adafruit/Adafruit-Mini-TFT-with-Joystick-Featherwing-PCB/Adafruit Mini TFT Wing.brd

## EAGLE design Adafruit Mini TFT Wing.brd (2018-11-03)

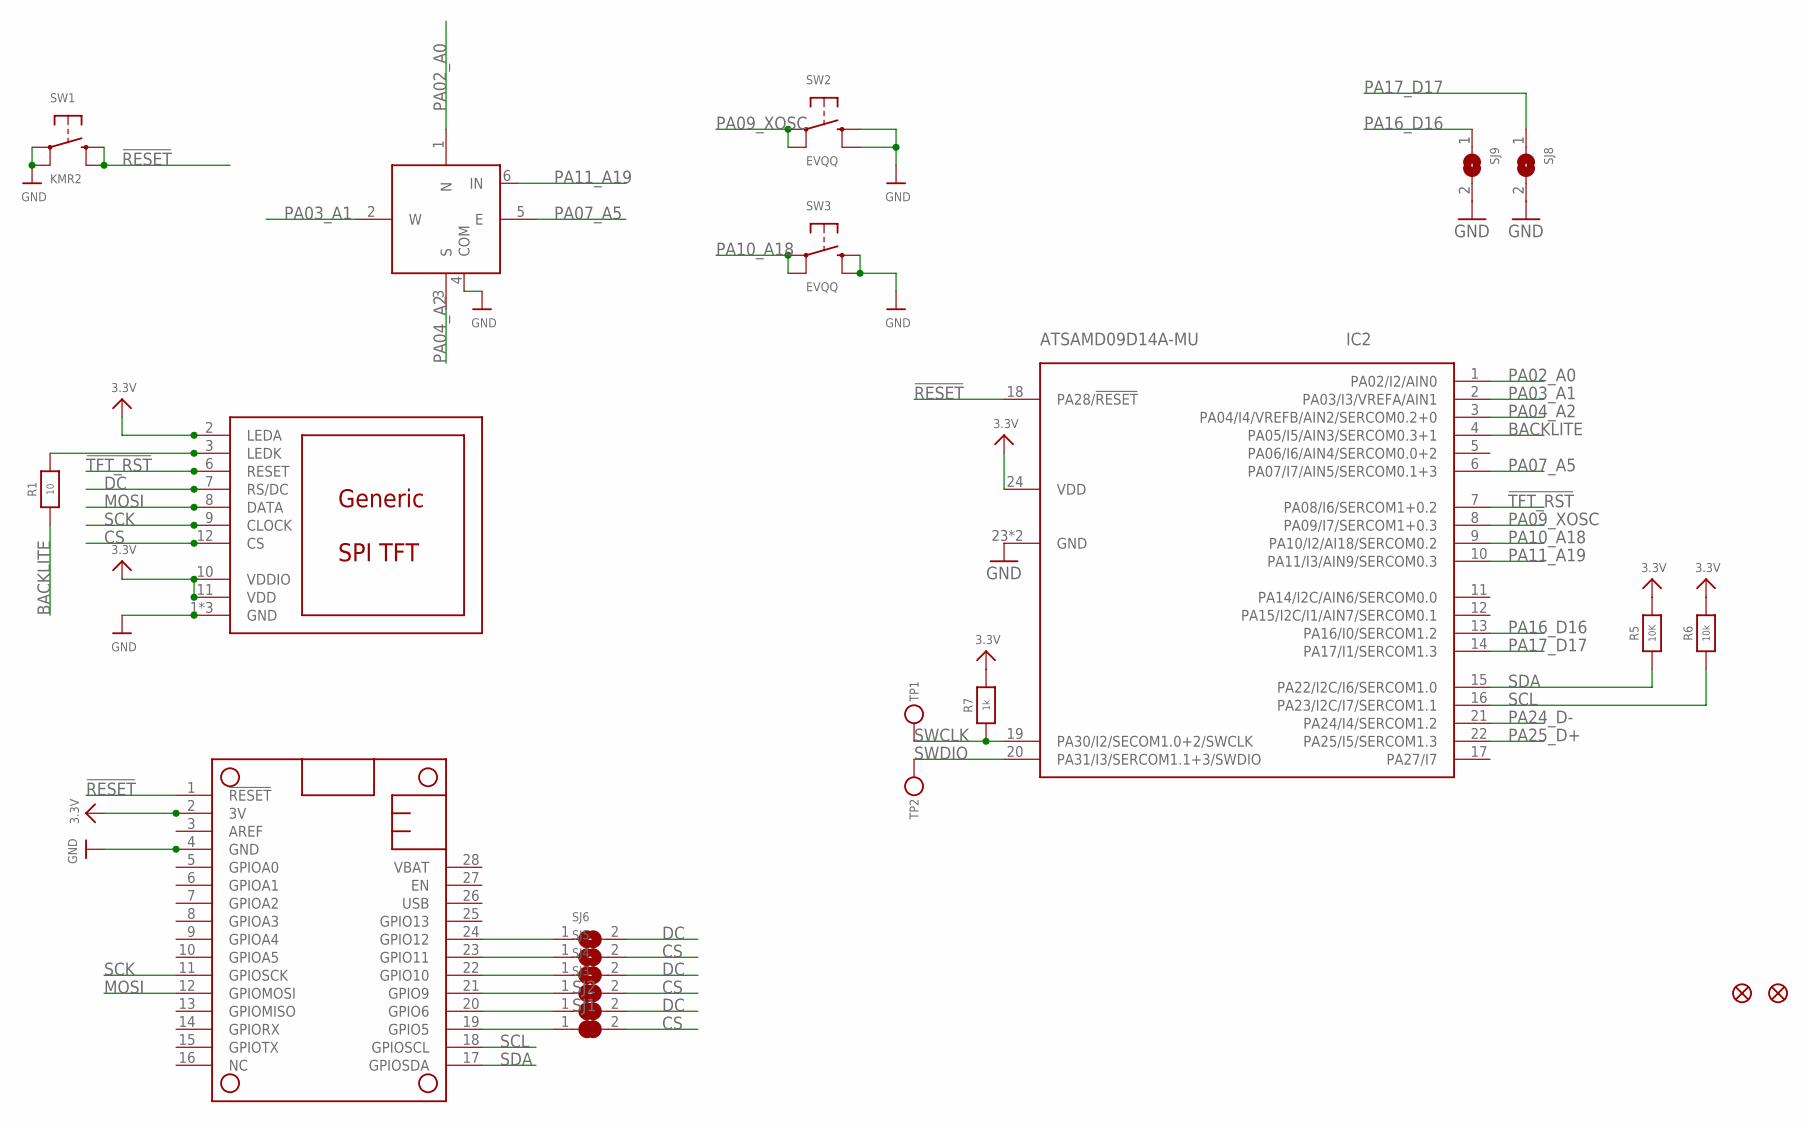
[picture p2: schematic Adafruit Mini TFT Wing.sch]

Parts:
FID1, FID2: FIDUCIAL_1MM
IC2: ATSAMD09D14A-MU; QFN24_4MM
MS1: FEATHERWING
R1: 10; 0603-NO
R5: 10K; 0603-NO
R6: 10k; 0603-NO
R7: 1k; 0603-NO
SJ1, SJ2: SOLDERJUMPER_CLOSED; SOLDERJUMPER_CLOSEDWIRE
SJ3, SJ4, SJ5, SJ6, SJ8, SJ9: SOLDERJUMPER; SOLDERJUMPER_ARROW_NOPASTE
SW1: KMR2; BTN_KMR2_4.6X2.8
SW2, SW3: EVQQ; EVQ-Q2_SMALLER
SW4: NAVSWITCHSKQUABAUE010; SKQUBAE010
TP1, TP2: TESTPOINTROUND2MM; TESTPOINT_ROUND_2MM
U$2: DISP_LCD_0.9IN_160X80; TFT_0.96IN_160X80

Connections:
3.3V: IC2.24 (VDD), MS1.2 (3V), R5.2, R6.2, R7.2, U$2.2 (LEDA), U$2.10 (VDDIO), U$2.11 (VDD)
!RESET: IC2.18 (PA28/!RESET), MS1.1 (!RESET), SW1.B (S), SW1.B' (S1)
!TFT_RST: IC2.7 (PA08/I6/SERCOM1+0.2), U$2.6 (RESET)
BACKLITE: IC2.4 (PA05/I5/AIN3/SERCOM0.3+1), R1.1
CS: SJ1.2, SJ3.2, SJ5.2, U$2.12 (CS)
DC: SJ2.2, SJ4.2, SJ6.2, U$2.7 (RS/DC)
GND: IC2.23 (GND), IC2.THERM (GND), MS1.4 (GND), SJ8.2, SJ9.2, SW1.A, SW1.A' (P1), SW2.B (S), SW2.B' (S1), SW3.B (S), SW3.B' (S1), SW4.4 (COM), U$2.1 (GND), U$2.5 (GND), U$2.13 (GND)
MOSI: MS1.12 (GPIOMOSI), U$2.8 (DATA)
unnamed: MS1.20 (GPIO6), SJ2.1
unnamed: MS1.19 (GPIO5), SJ1.1
unnamed: MS1.21 (GPIO9), SJ3.1
unnamed: MS1.22 (GPIO10), SJ4.1
unnamed: MS1.23 (GPIO11), SJ5.1
unnamed: MS1.24 (GPIO12), SJ6.1
unnamed: R1.2, U$2.3 (LEDK)
PA02_A0: IC2.1 (PA02/I2/AIN0), SW4.1 (N)
PA03_A1: IC2.2 (PA03/I3/VREFA/AIN1), SW4.2 (W)
PA04_A2: IC2.3 (PA04/I4/VREFB/AIN2/SERCOM0.2+0), SW4.3 (S)
PA07_A5: IC2.6 (PA07/I7/AIN5/SERCOM0.1+3), SW4.5 (E)
PA09_XOSC: IC2.8 (PA09/I7/SERCOM1+0.3), SW2.A, SW2.A' (P1)
PA10_A18: IC2.9 (PA10/I2/AI18/SERCOM0.2), SW3.A, SW3.A' (P1)
PA11_A19: IC2.10 (PA11/I3/AIN9/SERCOM0.3), SW4.6 (IN)
PA16_D16: IC2.13 (PA16/I0/SERCOM1.2), SJ9.1
PA17_D17: IC2.14 (PA17/I1/SERCOM1.3), SJ8.1
PA24_D-: IC2.21 (PA24/I4/SERCOM1.2)
PA25_D+: IC2.22 (PA25/I5/SERCOM1.3)
SCK: MS1.11 (GPIOSCK), U$2.9 (CLOCK)
SCL: IC2.16 (PA23/I2C/I7/SERCOM1.1), MS1.18 (GPIOSCL), R6.1
SDA: IC2.15 (PA22/I2C/I6/SERCOM1.0), MS1.17 (GPIOSDA), R5.1
SWCLK: IC2.19 (PA30/I2/SECOM1.0+2/SWCLK), R7.1, TP1.P$1
SWDIO: IC2.20 (PA31/I3/SERCOM1.1+3/SWDIO), TP2.P$1

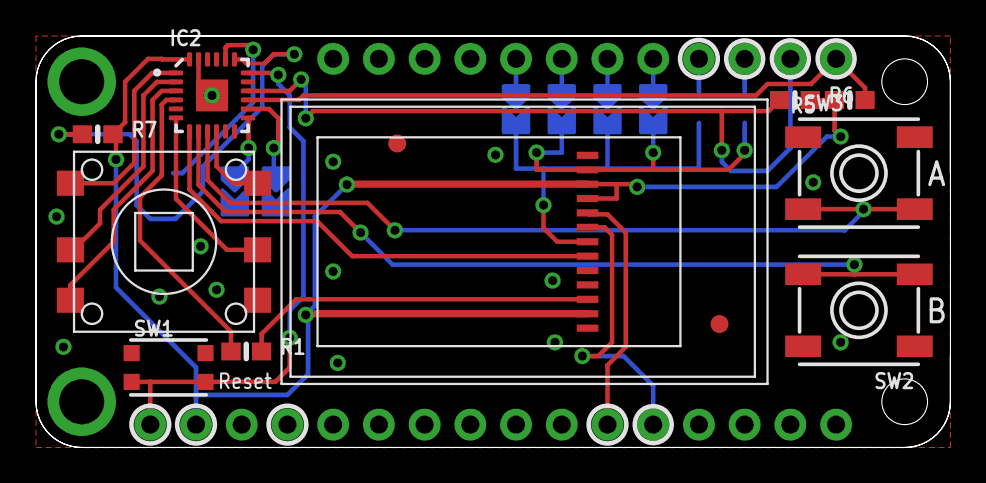
[picture p3: board Adafruit Mini TFT Wing.brd from above]

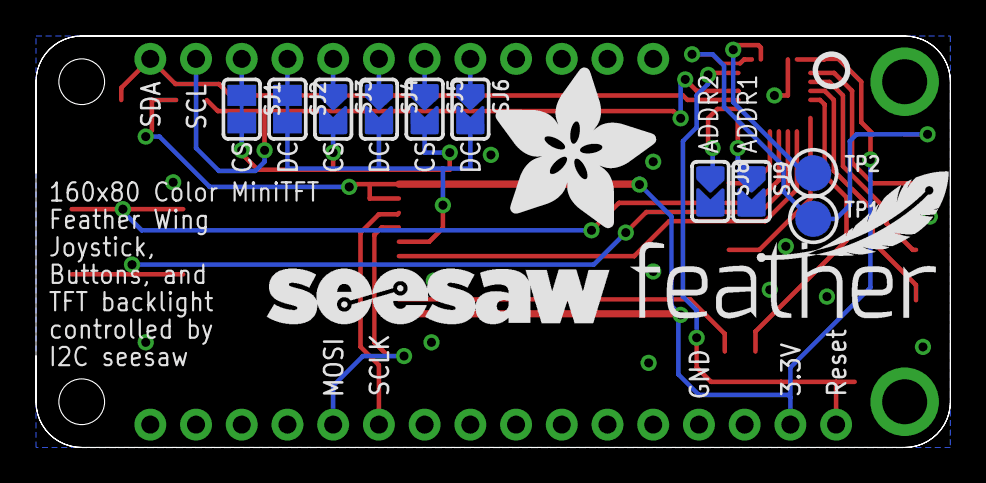
[picture p4: board Adafruit Mini TFT Wing.brd from below]

Board: 2 copper layers, 50.8 x 22.9 mm, 27 parts (14 on the bottom side), 29 nets.

Other parts of the board:
U$4: FEATHERLOGO_MED
U$8: SEESAW_LOGO
U$12: ADAFRUIT_9MM
U$14: PCBFEAT-REV-040
